Alex-Riviello/power_supply_mk1/python_code/Program layout.png

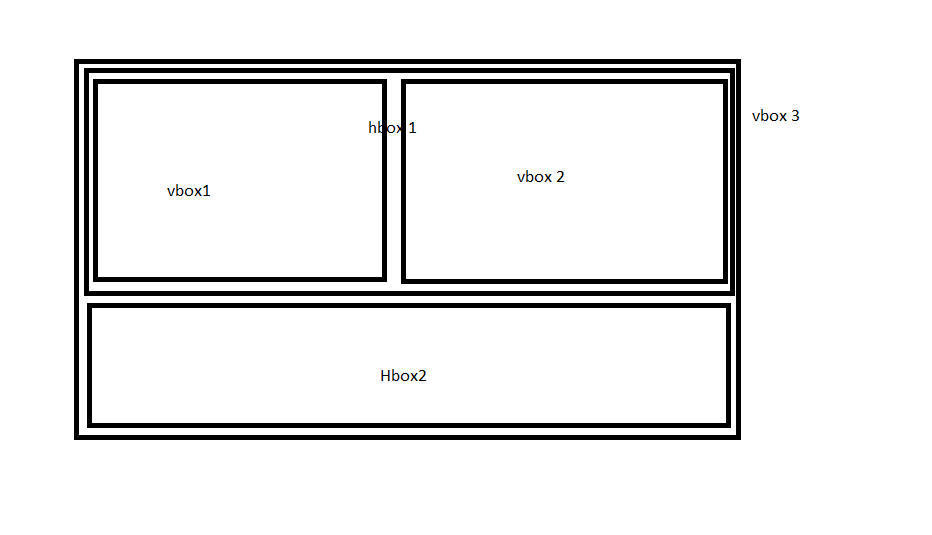
python_code/Program layout.png
