Alex-Riviello/power_supply_mk1/BOM/52247913.xlsx

# | Quantity | Part Number | Manufacturer Part Number | Description | Customer Reference | Backorder | Unit Price | Extended Price
1 | 3 | 296-17616-6-ND | UA78M05IDCYR | IC REG LINEAR 5V 500MA SOT223-4 |  | 0 | 4.07667 | 12.23
2 | 3 | 296-22949-1-ND | UA78M33QDCYRG4Q1 | IC REG LIN 3.3V 500MA SOT223-4 |  | 0 | 1 | 3.00
3 | 2 | LM337IMPX/NOPBCT-ND | LM337IMPX/NOPB | IC REG LIN NEG ADJ 1A SOT223-4 |  | 0 | 2.33 | 4.66
4 | 2 | LM317EMP/NOPBCT-ND | LM317EMP/NOPB | IC REG LIN POS ADJ 1A SOT223-4 |  | 0 | 1.83 | 3.66
5 | 100 | 2N7002-FDICT-ND | 2N7002-7-F | MOSFET N-CH 60V 115MA SOT23-3 |  | 0 | 0.1087 | 10.87
6 | 10 | FOD817DSDCT-ND | FOD817DSD | OPTOISOLATOR 5KV TRANSISTOR 4SMD |  | 0 | 0.541 | 5.41
7 | 25 | 160-1426-1-ND | LTST-C171KGKT | LED GREEN CLEAR 0805 SMD |  | 0 | 0.2224 | 5.56
8 | 25 | 160-1427-1-ND | LTST-C171KRKT | LED RED CLEAR 0805 SMD |  | 0 | 0.2224 | 5.56
9 | 10 | 445-5684-1-ND | CGA4J2X7R1H334K125AA | CAP CER 0.33UF 50V X7R 0805 |  | 0 | 0.255 | 2.55
10 | 10 | 399-8265-1-ND | T491A105K035AT | CAP TANT 1UF 35V 10% 1206 |  | 0 | 0.409 | 4.09
11 | 100 | 399-1170-1-ND | C0805C104K5RACTU | CAP CER 0.1UF 50V X7R 0805 |  | 0 | 0.0333 | 3.33
12 | 100 | 1276-1066-1-ND | CL21B105KAFNNNE | CAP CER 1UF 25V X7R 0805 |  | 0 | 0.0485 | 4.85
13 | 10 | 399-3734-1-ND | T491C106K025AT | CAP TANT 10UF 25V 10% 2312 |  | 0 | 0.654 | 6.54
14 | 10 | 1N4002RLGOSCT-ND | 1N4002RLG | DIODE GEN PURP 100V 1A DO41 |  | 0 | 0.276 | 2.76
15 | 4 | P.020AUCT-ND | ERJ-8BWFR020V | RES 0.02 OHM 1% 1W 1206 |  | 0 | 1.06 | 4.24
16 | 10 | 541-69.8FCT-ND | CRCW120669R8FKEA | RES SMD 69.8 OHM 1% 1/4W 1206 |  | 0 | 0.089 | 0.89
17 | 100 | RMCF1206FT100RDKR-ND | RMCF1206FT100R | RES SMD 100 OHM 1% 1/4W 1206 |  | 0 | 0.1152 | 11.52
18 | 10 | RMCF1206FT120RCT-ND | RMCF1206FT120R | RES SMD 120 OHM 1% 1/4W 1206 |  | 0 | 0.05 | 0.50
19 | 10 | P620FCT-ND | ERJ-8ENF6200V | RES SMD 620 OHM 1% 1/4W 1206 |  | 0 | 0.074 | 0.74
20 | 100 | RMCF1206FT1K00CT-ND | RMCF1206FT1K00 | RES SMD 1K OHM 1% 1/4W 1206 |  | 0 | 0.0202 | 2.02
21 | 6 | RHM1.1KAICT-ND | KTR18EZPF1101 | RES SMD 1.1K OHM 1% 1/4W 1206 |  | 0 | 0.36 | 2.16
22 | 100 | RMCF1206FT2K00CT-ND | RMCF1206FT2K00 | RES SMD 2K OHM 1% 1/4W 1206 |  | 0 | 0.0202 | 2.02
23 | 10 | YAG3855CT-ND | AC1206FR-072K7L | RES SMD 2.7K OHM 1% 1/4W 1206 |  | 0 | 0.087 | 0.87
24 | 10 | P4.99KFCT-ND | ERJ-8ENF4991V | RES SMD 4.99K OHM 1% 1/4W 1206 |  | 0 | 0.074 | 0.74
25 | 100 | P10.0KFCT-ND | ERJ-8ENF1002V | RES SMD 10K OHM 1% 1/4W 1206 |  | 0 | 0.0304 | 3.04
26 | 10 | P26.1KFCT-ND | ERJ-8ENF2612V | RES SMD 26.1K OHM 1% 1/4W 1206 |  | 0 | 0.074 | 0.74
27 | 10 | YAG3806CT-ND | AC1206FR-0710ML | RES SMD 10M OHM 1% 1/4W 1206 |  | 0 | 0.07 | 0.70
28 | 3 | HS350-ND | 529802B02500G | HEATSINK TO-220 W/PINS 1.5"TALL |  | 0 | 2.07 | 6.21
29 | 2 | ATS1130-ND | ATS-52150P-C1-R0 | HEAT SINK 15MM X 15MM X 17.5MM |  | 0 | 11.93 | 23.86
30 | 1 | 1597-1418-ND | 313070005 | 1W SOLAR PANEL 80X100 |  | 0 | 5.76 | 5.76
31 | 2 | 36-4628-ND | 4628 | FUSE HLDR CARTRIDGE 250V 5A PCB |  | 0 | 1.13 | 2.26
32 | 6 | A121194CT-ND | 3522240RFT | RES SMD 240 OHM 1% 3W 2512 |  | 0 | 1.21 | 7.26
33 | 6 | P180ALCT-ND | ERJ-P08J181V | RES SMD 180 OHM 5% 2/3W 1206 |  | 0 | 0.23 | 1.38
34 | 10 | P560ALCT-ND | ERJ-P08J561V | RES SMD 560 OHM 5% 2/3W 1206 |  | 0 | 0.196 | 1.96
35 | 1 | Q106-ND | 311007-01 | CORD 18AWG 3COND 79" BLACK SVT |  | 0 | 5.37 | 5.37
