Alex-Riviello/power_supply_mk1/(list of files, cad)

Other CAD files:
mcu_code/Keil 8051 v9.53 - Debug/src/InitDevice.OBJ
mcu_code/Keil 8051 v9.53 - Release/src/SILABS_STARTUP.OBJ
mcu_code/Keil 8051 v9.53 - Debug/src/Interrupts.OBJ
mcu_code/Keil 8051 v9.53 - Release/src/EFM8BB1_SMBus_SlaveMultibyteHWACK.OBJ
mcu_code/Keil 8051 v9.53 - Debug/src/EFM8BB1_SMBus_SlaveMultibyteHWACK.OBJ
mcu_code/Keil 8051 v9.53 - Release/src/Interrupts.OBJ
mcu_code/Keil 8051 v9.53 - Debug/src/SILABS_STARTUP.OBJ
mcu_code/Keil 8051 v9.53 - Release/src/InitDevice.OBJ
