Alex-Riviello/power_supply_mk1/kicad_psu_mk1/Power_Supply_Rev01.pdf

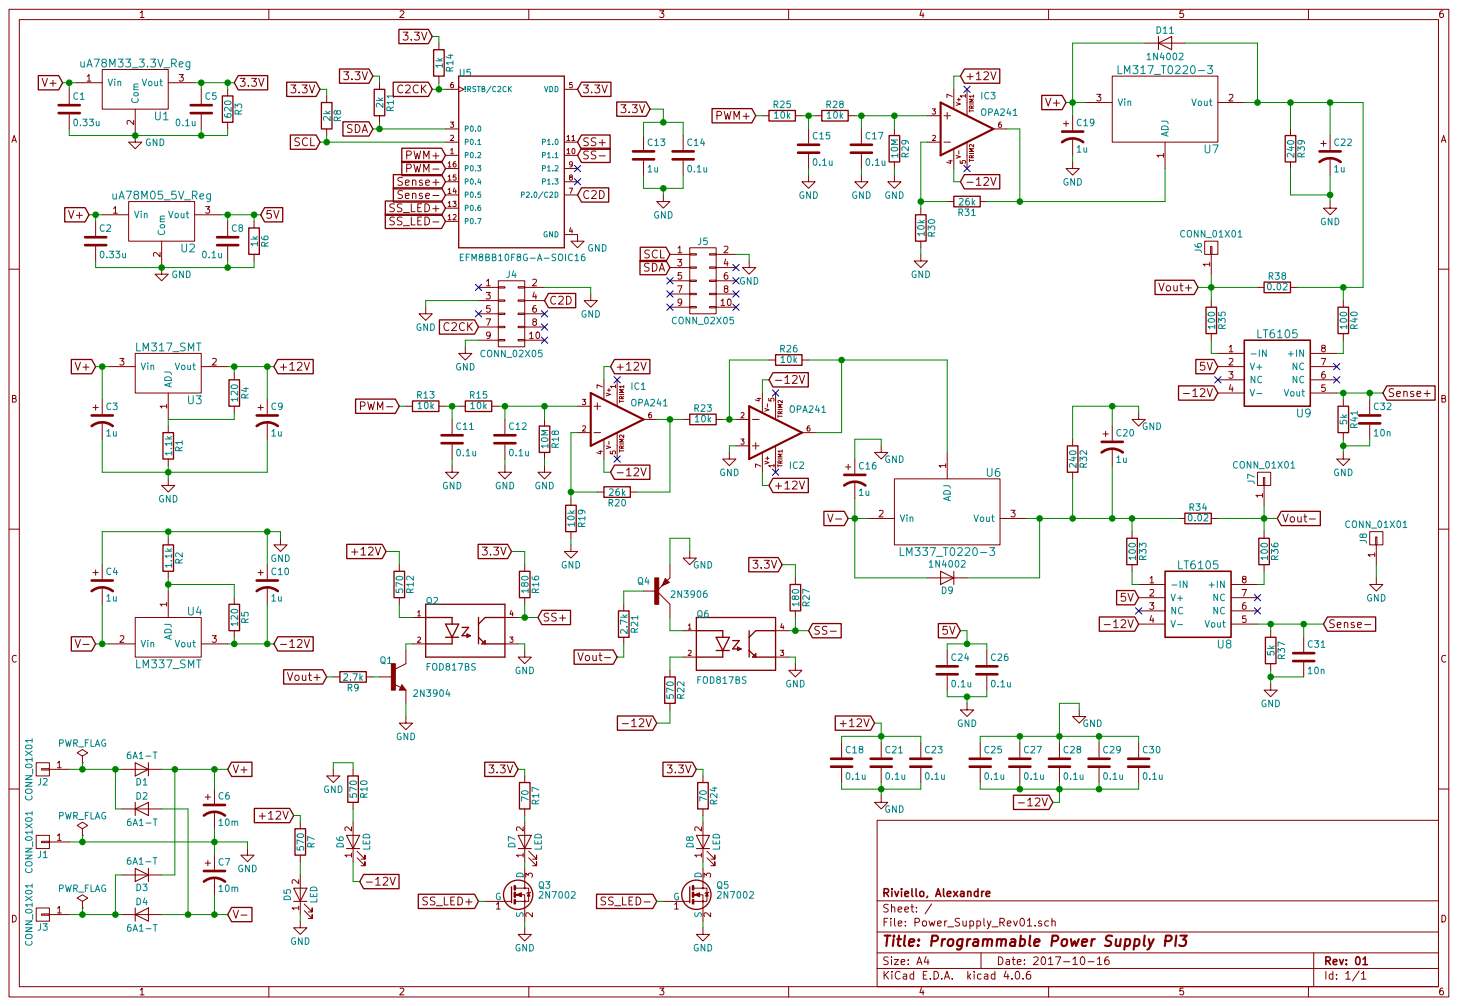
[picture p11: page 1]

File: Power_Supply_Rev01.sch Sheet: / Riviello, Alexandre

Id: 1/1 Title: Programmable Power Supply PI3
