Alex-Riviello/power_supply_mk1/kicad_psu_mk1/Power_Supply_Rev01.kicad_pcb

## KiCad design kicad_psu_mk1/Power_Supply_Rev01.kicad_pcb (2020-07-14)

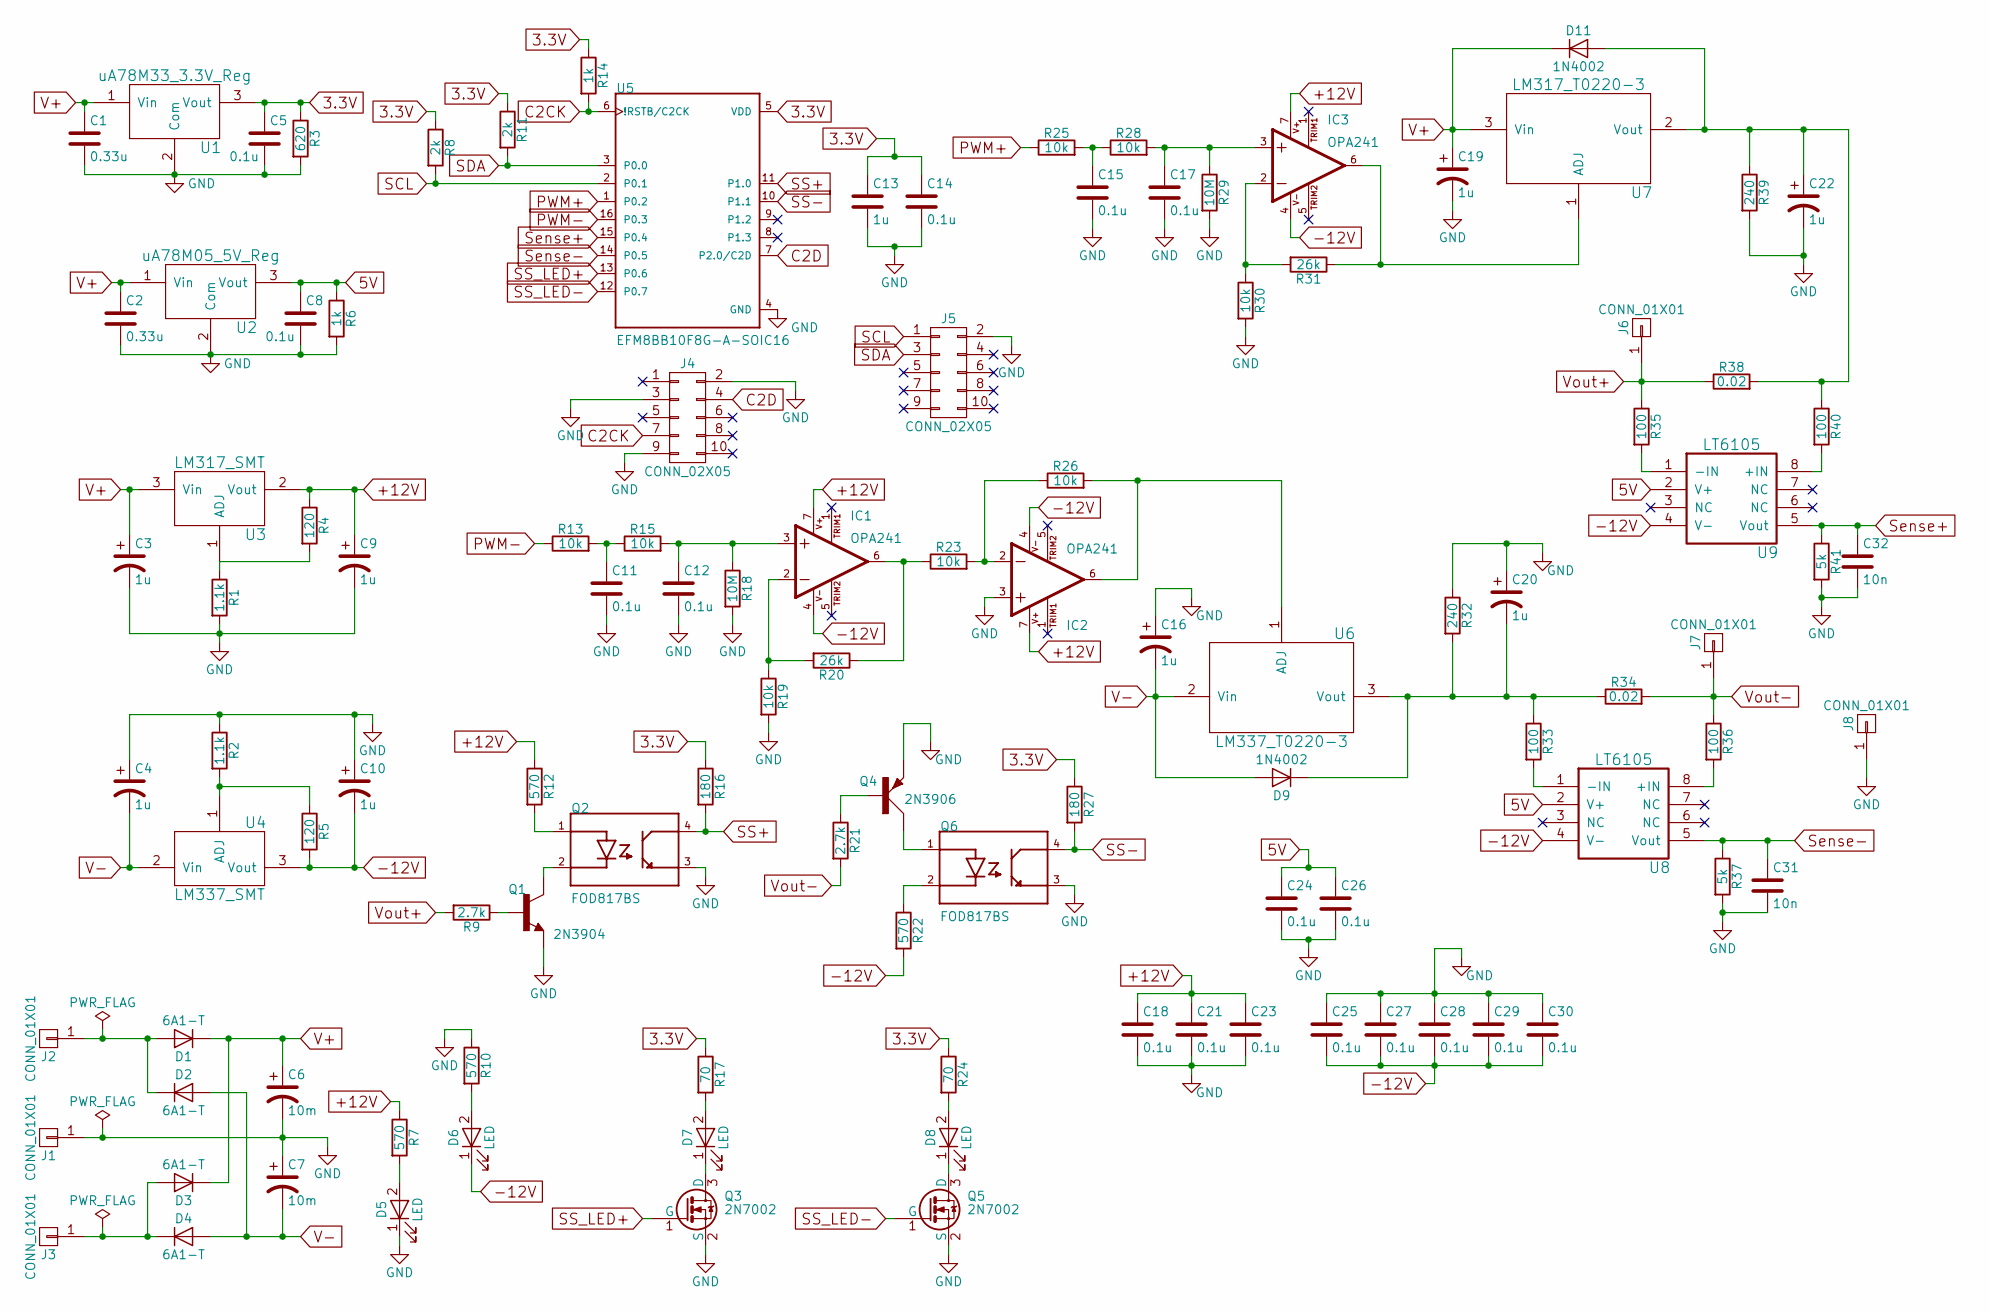
[picture p12: schematic Power_Supply_Rev01.sch, Programmable Power Supply PI3]

Parts:
C1, C2: 0.33u; C_0805_HandSoldering
C3, C4, C9, C10, C16, C19, C20, C22: 1u; CP_Tantalum_Case-A_EIA-3216-18_Hand
C5, C8, C11, C12, C14, C15, C17, C18, C21, C23, C24, C25, C26, C27, C28, C29, C30: 0.1u; C_0805_HandSoldering
C6, C7: 10m; CP_Radial_D22.0mm_P10.00mm_SnapIn
C13: 1u; C_0805_HandSoldering
C31, C32: 10n; C_0805_HandSoldering
D1, D2, D3, D4: 6A1-T; D_P600_R-6_P20.00mm_Horizontal
D5, D6, D7, D8: LED; LED_0805_HandSoldering
D9, D11: 1N4002; D_DO-41_SOD81_P7.62mm_Horizontal
IC1, IC2, IC3: OPA241; DIL08
J1, J2, J3, J6, J7, J8: CONN_01X01; SolderWirePad_single_SMD_5x10mm
J4, J5: CONN_02X05; Pin_Header_Straight_2x05_Pitch2.54mm
Q1: 2N3904; TO92
Q2, Q6: FOD817BS; SOIC254P1016X385-4N
Q3, Q5: 2N7002; SOT-23
Q4: 2N3906; TO92D
R1, R2: 1.1k; R_1206_HandSoldering
R3: 620; R_1206_HandSoldering
R4, R5: 120; R_1206_HandSoldering
R6, R14: 1k; R_1206_HandSoldering
R7, R10, R12, R22: 570; R_1206_HandSoldering
R8, R11: 2k; R_1206_HandSoldering
R9, R21: 2.7k; R_1206_HandSoldering
R13, R15, R19, R23, R25, R26, R28, R30: 10k; R_1206_HandSoldering
R16, R27: 180; R_1206_HandSoldering
R17, R24: 70; R_1206_HandSoldering
R18, R29: 10M; R_1206_HandSoldering
R20, R31: 26k; R_1206_HandSoldering
R32, R39: 240; R_2512_HandSoldering
R33, R35, R36, R40: 100; R_1206_HandSoldering
R34, R38: 0.02; R_1206_HandSoldering
R37, R41: 5k; R_1206_HandSoldering
U1: uA78M33_3.3V_Reg; SOT230P700X180-4N
U2: uA78M05_5V_Reg; SOT230P700X180-4N
U3: LM317_SMT; SOT230P700X180-4N
U4: LM337_SMT; SOT230P700X180-4N
U5: EFM8BB10F8G-A-SOIC16; SOIC127P600X175-16N
U6: LM337_T0220-3; TO-220-3_Horizontal
U7: LM317_T0220-3; TO-220-3_Horizontal
U8, U9: LT6105; MSOP-8_3x3mm_Pitch0.65mm

Connections:
3.3V: C5.1, C13.1, C14.1, R3.1, R8.1, R11.1, R14.1, R16.1, R17.1, R24.1, R27.1, U1.3 (Vout), U5.5 (VDD)
5V: C8.1, C24.1, C26.1, R6.1, U2.3 (Vout), U8.2 (V+), U9.2 (V+)
+12V: C9.1, C18.1, C21.1, C23.1, IC1.7 (V+), IC2.7 (V+), IC3.7 (V+), R4.1, R7.1, R12.1, U3.2 (Vout)
-12V: C10.2, C25.2, C27.2, C28.2, C29.2, C30.2, D6.1 (K), IC1.4 (V-), IC2.4 (V-), IC3.4 (V-), R5.2, R22.2, U4.3 (Vout), U8.4 (V-), U9.4 (V-)
C2CK: J4.7, R14.2, U5.6 (!RSTB/C2CK)
C2D: J4.4, U5.7 (P2.0/C2D)
GND: C1.2, C2.2, C3.2, C4.1, C5.2, C6.2, C7.1, C8.2, C9.2, C10.1, C11.2, C12.2, C13.2, C14.2, C15.2, C16.1, C17.2, C18.2, C19.2, C20.1, C21.2, C22.2, C23.2, C24.2, C25.1, C26.2, C27.1, C28.1, C29.1, C30.1, C31.2, C32.2, D5.1 (K), IC2.3 (+IN), J1.1, J4.2, J4.3, J4.9, J5.2, J8.1, Q1.3 (E), Q2.3 (EMITTER), Q3.2 (S), Q4.E, Q5.2 (S), Q6.3 (EMITTER), R1.2, R2.1, R3.2, R6.2, R10.1, R18.2, R19.2, R29.2, R30.2, R32.1, R37.2, R39.2, R41.2, U1.2 (Com), U2.2 (Com), U5.4 (GND)
unnamed: C11.1, R13.2, R15.1
unnamed: C12.1, IC1.3 (+IN), R15.2, R18.1
unnamed: C15.1, R25.2, R28.1
unnamed: C17.1, IC3.3 (+IN), R28.2, R29.1
unnamed: C20.2, D9.1 (K), R32.2, R33.1, R34.1, U6.3 (Vout)
unnamed: C22.1, D11.2 (A), R38.2, R39.1, R40.1, U7.2 (Vout)
unnamed: D1.2 (A), D2.1 (K), J2.1
unnamed: D3.2 (A), D4.1 (K), J3.1
unnamed: D5.2 (A), R7.2
unnamed: D6.2 (A), R10.2
unnamed: D7.1 (K), Q3.3 (D)
unnamed: D7.2 (A), R17.2
unnamed: D8.1 (K), Q5.3 (D)
unnamed: D8.2 (A), R24.2
unnamed: IC1.2 (-IN), R19.1, R20.2
unnamed: IC1.6 (OUT), R20.1, R23.1
unnamed: IC2.2 (-IN), R23.2, R26.1
unnamed: IC2.6 (OUT), R26.2, U6.1 (ADJ)
unnamed: IC3.2 (-IN), R30.1, R31.2
unnamed: IC3.6 (OUT), R31.1, U7.1 (ADJ)
unnamed: Q1.1 (C), Q2.2 (CATHODE)
unnamed: Q1.2 (B), R9.1
unnamed: Q2.1 (ANODE), R12.2
unnamed: Q4.B, R21.1
unnamed: Q4.C, Q6.1 (ANODE)
unnamed: Q6.2 (CATHODE), R22.1
unnamed: R1.1, R4.2, U3.1 (ADJ)
unnamed: R2.2, R5.1, U4.1 (ADJ)
unnamed: R33.2, U8.1 (-IN)
unnamed: R35.2, U9.1 (-IN)
unnamed: R36.2, U8.8 (+IN)
unnamed: R40.2, U9.8 (+IN)
PWM+: R25.1, U5.1 (P0.2)
PWM-: R13.1, U5.16 (P0.3)
SCL: J5.1, R8.2, U5.2 (P0.1)
SDA: J5.3, R11.2, U5.3 (P0.0)
SS+: Q2.4 (COLLECTOR), R16.2, U5.11 (P1.0)
SS-: Q6.4 (COLLECTOR), R27.2, U5.10 (P1.1)
SS_LED+: Q3.1 (G), U5.13 (P0.6)
SS_LED-: Q5.1 (G), U5.12 (P0.7)
Sense+: C32.1, R41.1, U5.15 (P0.4), U9.5 (Vout)
Sense-: C31.1, R37.1, U5.14 (P0.5), U8.5 (Vout)
V+: C1.1, C2.1, C3.1, C6.1, C19.1, D1.1 (K), D3.1 (K), D11.1 (K), U1.1 (Vin), U2.1 (Vin), U3.3 (Vin), U7.3 (Vin)
V-: C4.2, C7.2, C16.2, D2.2 (A), D4.2 (A), D9.2 (A), U4.2 (Vin), U6.2 (Vin)
Vout+: J6.1, R9.2, R35.1, R38.1
Vout-: J7.1, R21.2, R34.2, R36.1

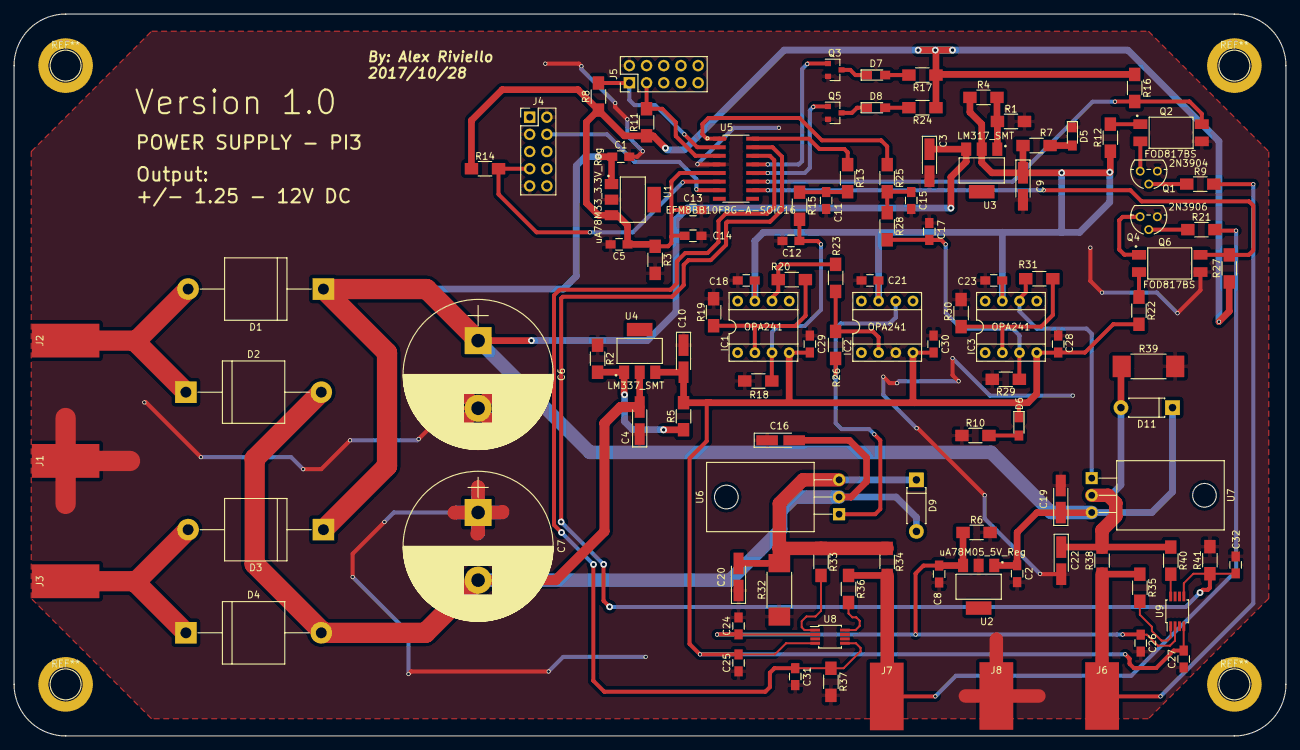
[picture p13: board Power_Supply_Rev01.kicad_pcb from above]

Board: 2 copper layers, 188.0 x 106.7 mm, 109 parts (0 on the bottom side), 53 nets.
