Alex-Riviello/power_supply_mk1/(commit log)

2020-07-14 Added project to repo
    [52247913.xlsx, EFM8BB1_SMBus_SlaveMultibyteHWACK.OBJ, InitDevice.OBJ, Interrupts.OBJ, Power_Supply_Rev01.kicad_pcb, Power_Supply_Rev01.sch, SILABS_STARTUP.OBJ]
2020-07-14 Added picture of finished prototype
    [EFM8BB1_SMBus_SlaveMultibyteHWACK.OBJ, InitDevice.OBJ, Interrupts.OBJ, SILABS_STARTUP.OBJ]
